chrisduerr/undeadsplit/README.md

# Undead Split Keyboard (v3)

Undead Split v3 is the third revision of my selfmade split mechanical keyboard.
