chrisduerr/undeadsplit/case/case.FCStd

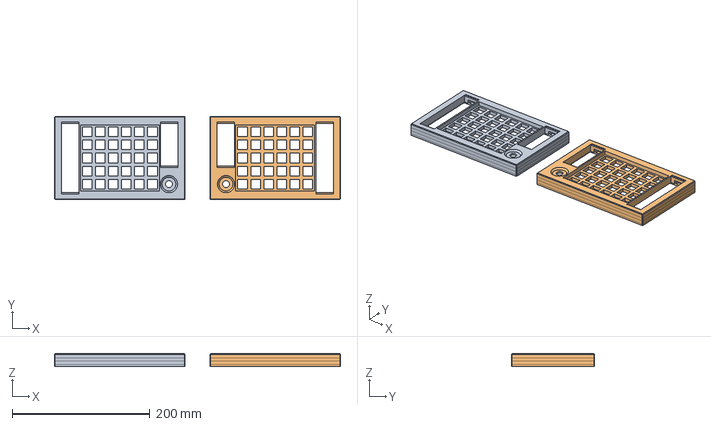
[picture p1: CAD file, 2024-12-27]
case/case.FCStd
416.0 x 121.0 x 18.5 mm
Body (Mirror #1)
