chrisduerr/undeadsplit/pcb/undead_split.kicad_pcb

## KiCad design pcb/undead_split.kicad_pcb (2025-04-27)

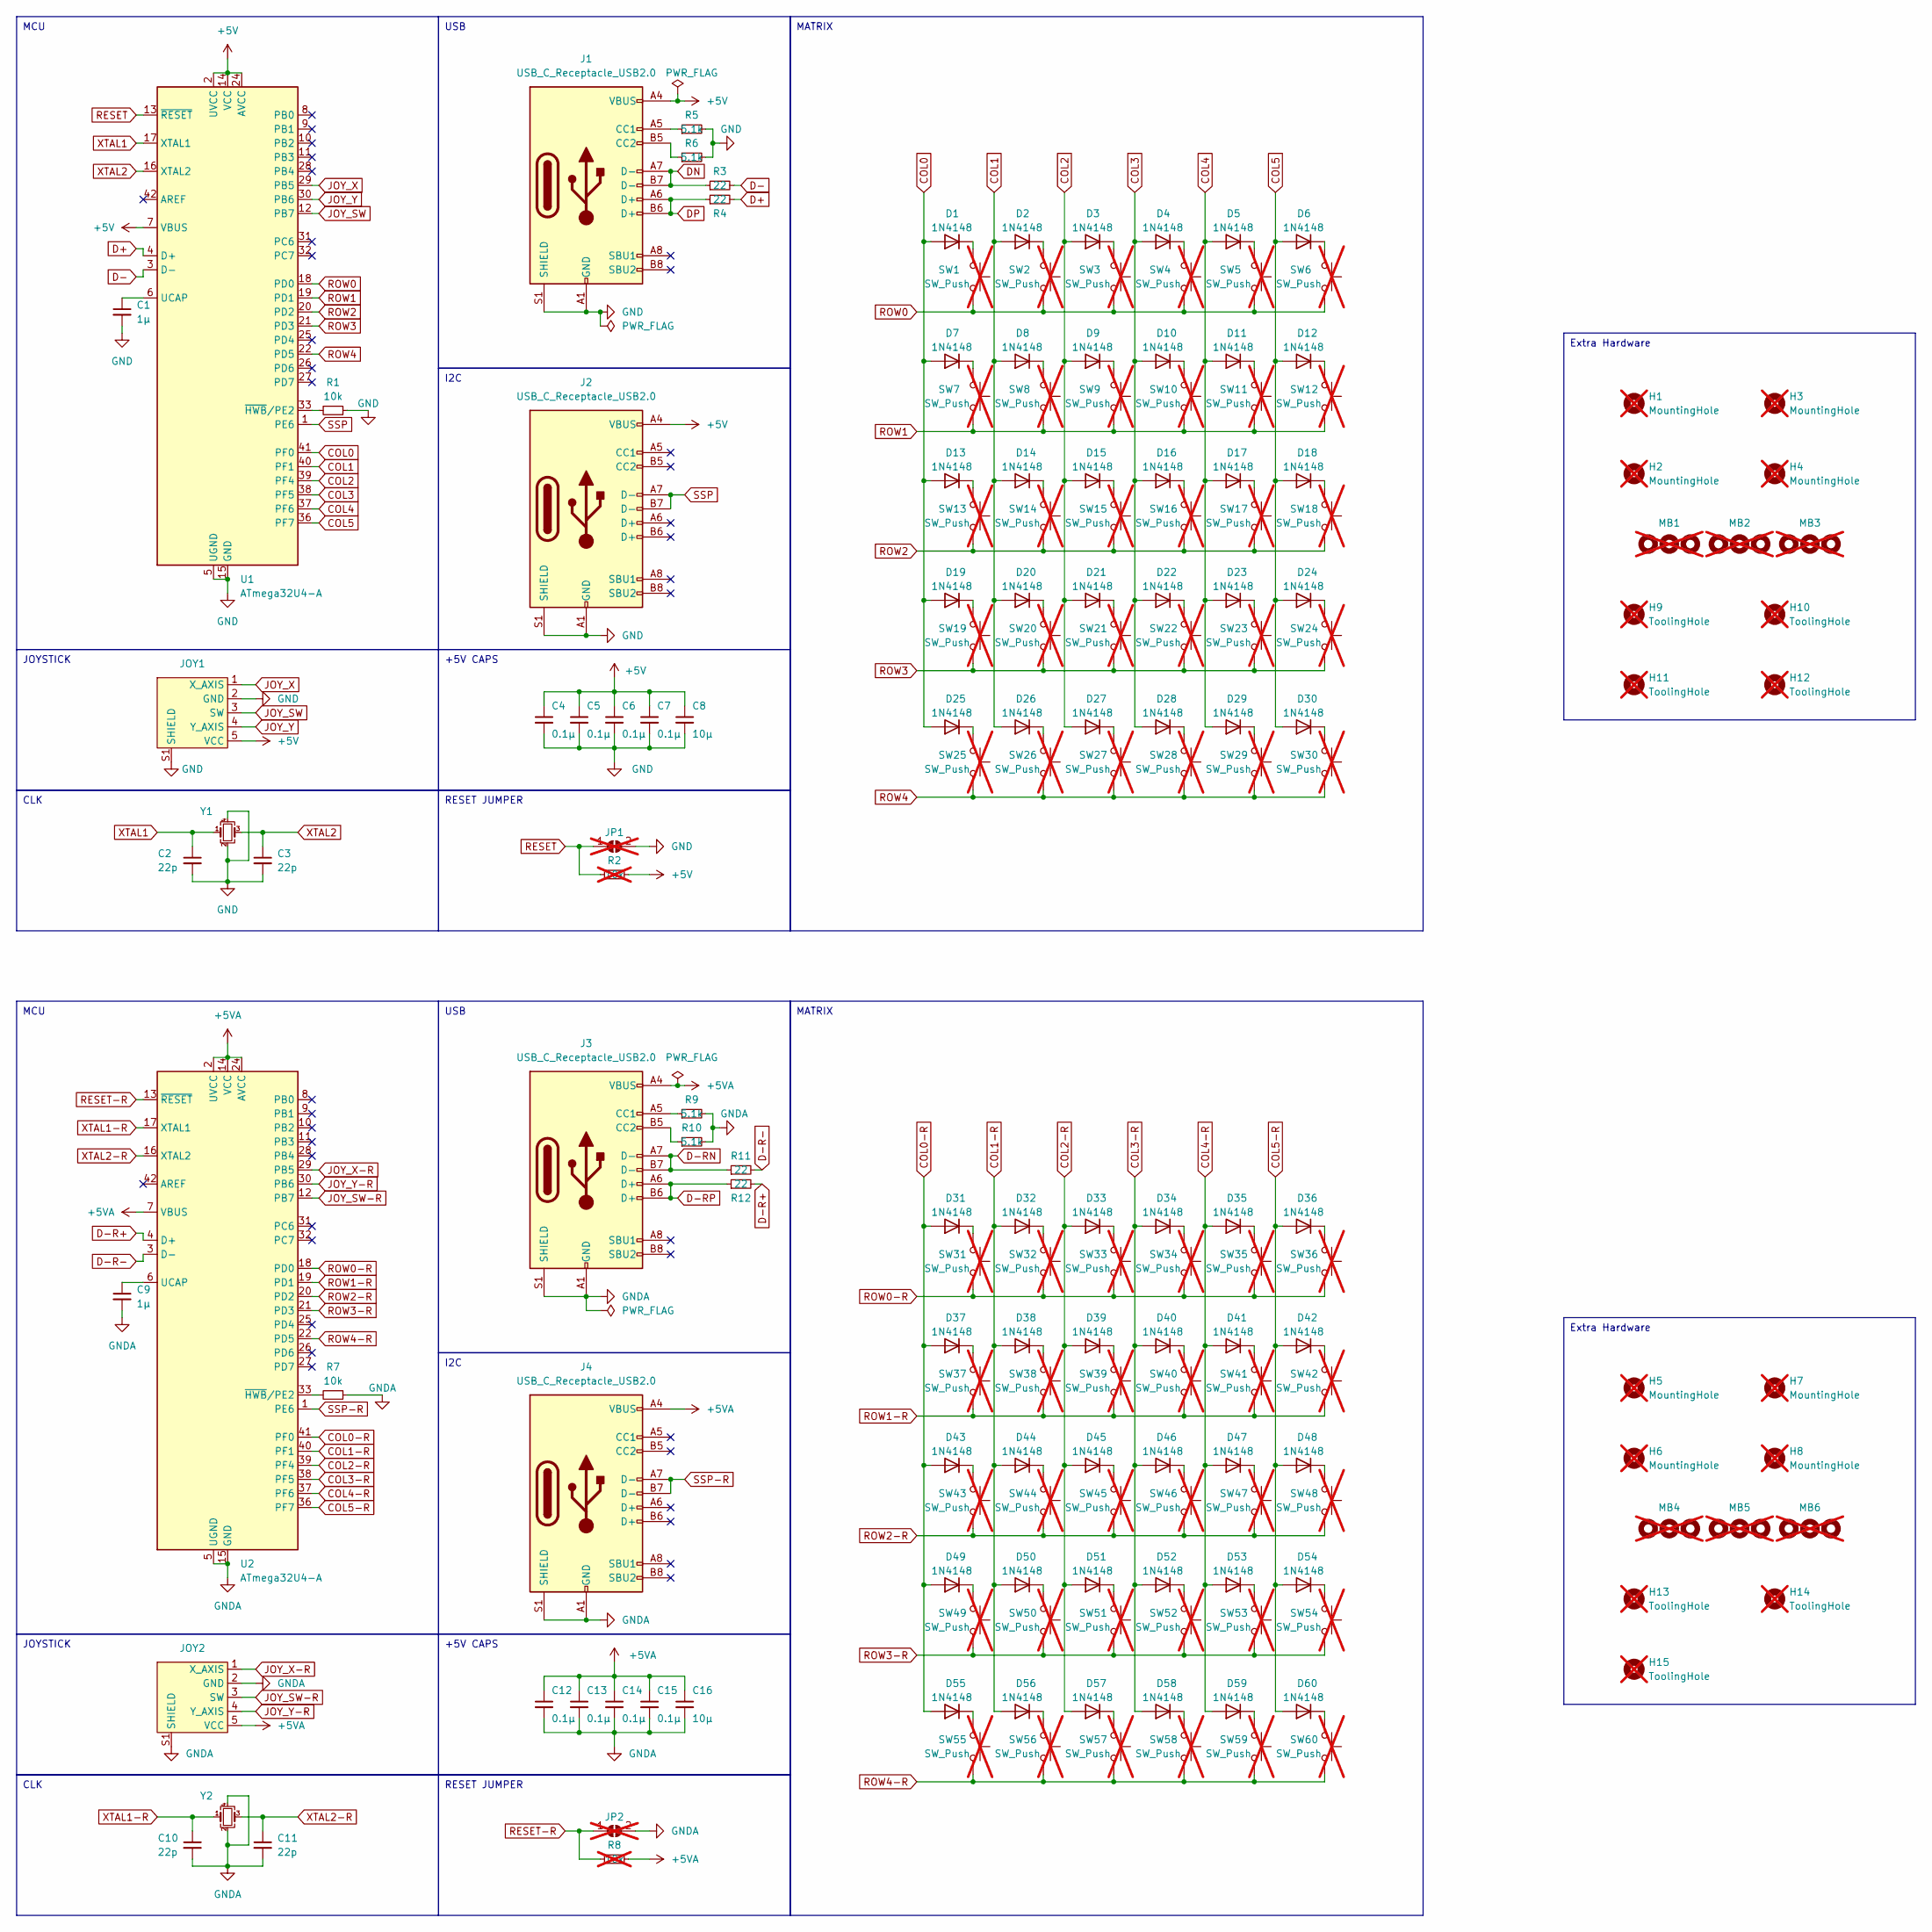
[picture p2: schematic undead_split.kicad_sch, Undead Split]

Parts:
C1, C9: 1µ; capacitor; JLCPCB Part # C28323
C2, C3, C10, C11: 22p; capacitor; JLCPCB Part # C1804
C4, C5, C6, C7, C12, C13, C14, C15: 0.1µ; capacitor; JLCPCB Part # C1711
C8, C16: 10µ; capacitor; JLCPCB Part # C17024
D1, D2, D3, D4, D5, D6, D7, D8, D9, D10, D11, D12, D13, D14, D15, D16, D17, D18, D19, D20, D21, D22, D23, D24, D25, D26, D27, D28, D29, D30, D31, D32, D33, D34, D35, D36, D37, D38, D39, D40, D41, D42, D43, D44, D45, D46, D47, D48, D49, D50, D51, D52, D53, D54, D55, D56, D57, D58, D59, D60: 1N4148; D_DO-35_SOD27_P7.62mm_Horizontal; JLCPCB Part # C402212
H1, H2, H3, H4, H5, H6, H7, H8: MountingHole; MountingHole_2.2mm_M2; not fitted
H9, H10, H11, H12, H13, H14, H15: ToolingHole; tooling_hole; not fitted
J1, J2, J3, J4: USB_C_Receptacle_USB2.0; USB_C_Receptacle_GCT_USB4105-xx-A_16P_TopMnt_Horizontal; JLCPCB Part # C393939
JOY1, JOY2: joycon_joystick; JLCPCB Part # C5213747
JP1, JP2: SolderJumper-2_P1.3mm_Open_Pad1.0x1.5mm; not fitted
MB1, MB2, MB3, MB4, MB5, MB6: mouse_bites; not fitted
R1, R7: 10k; resistor; JLCPCB Part # C17414
R2, R8: 10k; resistor; JLCPCB Part # C17414; not fitted
R3, R4, R11, R12: 22; resistor; JLCPCB Part # C17561
R5, R6, R9, R10: 5.1k; resistor; JLCPCB Part # C27834
SW1, SW2, SW3, SW4, SW5, SW6, SW7, SW8, SW9, SW10, SW11, SW12, SW13, SW14, SW15, SW16, SW17, SW18, SW19, SW20, SW21, SW22, SW23, SW24, SW25, SW26, SW27, SW28, SW29, SW30, SW31, SW32, SW33, SW34, SW35, SW36, SW37, SW38, SW39, SW40, SW41, SW42, SW43, SW44, SW45, SW46, SW47, SW48, SW49, SW50, SW51, SW52, SW53, SW54, SW55, SW56, SW57, SW58, SW59, SW60: SW_Push; CherryMX_Hotswap; not fitted
U1, U2: ATmega32U4-A; TQFP-44_10x10mm_P0.8mm; JLCPCB Part # C44854
Y1, Y2: Crystal_SMD_3225-4Pin_3.2x2.5mm_HandSoldering; JLCPCB Part # C13738

Connections:
+5V: C4.1, C5.1, C6.1, C7.1, C8.1, J1.A4 (VBUS), J1.A9 (VBUS), J1.B4 (VBUS), J1.B9 (VBUS), J2.A4 (VBUS), J2.A9 (VBUS), J2.B4 (VBUS), J2.B9 (VBUS), JOY1.5 (VCC), R2.2, U1.2 (UVCC), U1.7 (VBUS), U1.14 (VCC), U1.24 (AVCC), U1.34 (VCC), U1.44 (AVCC)
+5VA: C12.1, C13.1, C14.1, C15.1, C16.1, J3.A4 (VBUS), J3.A9 (VBUS), J3.B4 (VBUS), J3.B9 (VBUS), J4.A4 (VBUS), J4.A9 (VBUS), J4.B4 (VBUS), J4.B9 (VBUS), JOY2.5 (VCC), R8.2, U2.2 (UVCC), U2.7 (VBUS), U2.14 (VCC), U2.24 (AVCC), U2.34 (VCC), U2.44 (AVCC)
COL0: D1.2 (A), D7.2 (A), D13.2 (A), D19.2 (A), D25.2 (A), U1.41 (PF0)
COL0-R: D31.2 (A), D37.2 (A), D43.2 (A), D49.2 (A), D55.2 (A), U2.41 (PF0)
COL1: D2.2 (A), D8.2 (A), D14.2 (A), D20.2 (A), D26.2 (A), U1.40 (PF1)
COL1-R: D32.2 (A), D38.2 (A), D44.2 (A), D50.2 (A), D56.2 (A), U2.40 (PF1)
COL2: D3.2 (A), D9.2 (A), D15.2 (A), D21.2 (A), D27.2 (A), U1.39 (PF4)
COL2-R: D33.2 (A), D39.2 (A), D45.2 (A), D51.2 (A), D57.2 (A), U2.39 (PF4)
COL3: D4.2 (A), D10.2 (A), D16.2 (A), D22.2 (A), D28.2 (A), U1.38 (PF5)
COL3-R: D34.2 (A), D40.2 (A), D46.2 (A), D52.2 (A), D58.2 (A), U2.38 (PF5)
COL4: D5.2 (A), D11.2 (A), D17.2 (A), D23.2 (A), D29.2 (A), U1.37 (PF6)
COL4-R: D35.2 (A), D41.2 (A), D47.2 (A), D53.2 (A), D59.2 (A), U2.37 (PF6)
COL5: D6.2 (A), D12.2 (A), D18.2 (A), D24.2 (A), D30.2 (A), U1.36 (PF7)
COL5-R: D36.2 (A), D42.2 (A), D48.2 (A), D54.2 (A), D60.2 (A), U2.36 (PF7)
D+: R4.2, U1.4 (D+)
D-: R3.2, U1.3 (D-)
D-R+: R12.2, U2.4 (D+)
D-R-: R11.2, U2.3 (D-)
D-RN: J3.A7 (D-), J3.B7 (D-), R11.1
D-RP: J3.A6 (D+), J3.B6 (D+), R12.1
DN: J1.A7 (D-), J1.B7 (D-), R3.1
DP: J1.A6 (D+), J1.B6 (D+), R4.1
GND: C1.2, C2.2, C3.2, C4.2, C5.2, C6.2, C7.2, C8.2, J1.A1 (GND), J1.A12 (GND), J1.B1 (GND), J1.B12 (GND), J1.S1 (SHIELD), J2.A1 (GND), J2.A12 (GND), J2.B1 (GND), J2.B12 (GND), J2.S1 (SHIELD), JOY1.2 (GND), JOY1.S1 (SHIELD), JP1.2 (B), R1.1, R5.2, R6.2, U1.5 (UGND), U1.15 (GND), U1.23 (GND), U1.35 (GND), U1.43 (GND), Y1.2, Y1.4
GNDA: C9.2, C10.2, C11.2, C12.2, C13.2, C14.2, C15.2, C16.2, J3.A1 (GND), J3.A12 (GND), J3.B1 (GND), J3.B12 (GND), J3.S1 (SHIELD), J4.A1 (GND), J4.A12 (GND), J4.B1 (GND), J4.B12 (GND), J4.S1 (SHIELD), JOY2.2 (GND), JOY2.S1 (SHIELD), JP2.2 (B), R7.1, R9.2, R10.2, U2.5 (UGND), U2.15 (GND), U2.23 (GND), U2.35 (GND), U2.43 (GND), Y2.2, Y2.4
JOY_SW: JOY1.3 (SW), U1.12 (PB7)
JOY_SW-R: JOY2.3 (SW), U2.12 (PB7)
JOY_X: JOY1.1 (X_AXIS), U1.29 (PB5)
JOY_X-R: JOY2.1 (X_AXIS), U2.29 (PB5)
JOY_Y: JOY1.4 (Y_AXIS), U1.30 (PB6)
JOY_Y-R: JOY2.4 (Y_AXIS), U2.30 (PB6)
unnamed: D1.1 (K), SW1.1
unnamed: D2.1 (K), SW2.1
unnamed: D3.1 (K), SW3.1
unnamed: D4.1 (K), SW4.1
unnamed: D5.1 (K), SW5.1
unnamed: D6.1 (K), SW6.1
unnamed: D7.1 (K), SW7.1
unnamed: D8.1 (K), SW8.1
unnamed: D9.1 (K), SW9.1
unnamed: D10.1 (K), SW10.1
unnamed: D11.1 (K), SW11.1
unnamed: D12.1 (K), SW12.1
unnamed: D13.1 (K), SW13.1
unnamed: D14.1 (K), SW14.1
unnamed: D15.1 (K), SW15.1
unnamed: D16.1 (K), SW16.1
unnamed: D17.1 (K), SW17.1
unnamed: D18.1 (K), SW18.1
unnamed: D19.1 (K), SW19.1
unnamed: D20.1 (K), SW20.1
unnamed: D21.1 (K), SW21.1
unnamed: D22.1 (K), SW22.1
unnamed: D23.1 (K), SW23.1
unnamed: D24.1 (K), SW24.1
unnamed: D25.1 (K), SW25.1
unnamed: D26.1 (K), SW26.1
unnamed: D27.1 (K), SW27.1
unnamed: D28.1 (K), SW28.1
unnamed: D29.1 (K), SW29.1
unnamed: D30.1 (K), SW30.1
unnamed: D31.1 (K), SW31.1
unnamed: D32.1 (K), SW32.1
unnamed: D33.1 (K), SW33.1
unnamed: D34.1 (K), SW34.1
unnamed: D35.1 (K), SW35.1
unnamed: D36.1 (K), SW36.1
unnamed: D37.1 (K), SW37.1
unnamed: D38.1 (K), SW38.1
unnamed: D39.1 (K), SW39.1
unnamed: D40.1 (K), SW40.1
unnamed: D41.1 (K), SW41.1
unnamed: D42.1 (K), SW42.1
unnamed: D43.1 (K), SW43.1
unnamed: D44.1 (K), SW44.1
unnamed: D45.1 (K), SW45.1
unnamed: D46.1 (K), SW46.1
unnamed: D47.1 (K), SW47.1
unnamed: D48.1 (K), SW48.1
unnamed: D49.1 (K), SW49.1
unnamed: D50.1 (K), SW50.1
unnamed: D51.1 (K), SW51.1
unnamed: D52.1 (K), SW52.1
unnamed: D53.1 (K), SW53.1
unnamed: D54.1 (K), SW54.1
unnamed: D55.1 (K), SW55.1
unnamed: D56.1 (K), SW56.1
unnamed: D57.1 (K), SW57.1
unnamed: D58.1 (K), SW58.1
unnamed: D59.1 (K), SW59.1
unnamed: D60.1 (K), SW60.1
unnamed: J1.A5 (CC1), R5.1
unnamed: J1.B5 (CC2), R6.1
unnamed: J3.A5 (CC1), R9.1
unnamed: J3.B5 (CC2), R10.1
unnamed: C1.1, U1.6 (UCAP)
unnamed: R1.2, U1.33 (~HWB/PE2)
unnamed: C9.1, U2.6 (UCAP)
unnamed: R7.2, U2.33 (~HWB/PE2)
RESET: JP1.1 (A), R2.1, U1.13 (~RESET)
RESET-R: JP2.1 (A), R8.1, U2.13 (~RESET)
ROW0: SW1.2, SW2.2, SW3.2, SW4.2, SW5.2, SW6.2, U1.18 (PD0)
ROW0-R: SW31.2, SW32.2, SW33.2, SW34.2, SW35.2, SW36.2, U2.18 (PD0)
ROW1: SW7.2, SW8.2, SW9.2, SW10.2, SW11.2, SW12.2, U1.19 (PD1)
ROW1-R: SW37.2, SW38.2, SW39.2, SW40.2, SW41.2, SW42.2, U2.19 (PD1)
ROW2: SW13.2, SW14.2, SW15.2, SW16.2, SW17.2, SW18.2, U1.20 (PD2)
ROW2-R: SW43.2, SW44.2, SW45.2, SW46.2, SW47.2, SW48.2, U2.20 (PD2)
ROW3: SW19.2, SW20.2, SW21.2, SW22.2, SW23.2, SW24.2, U1.21 (PD3)
ROW3-R: SW49.2, SW50.2, SW51.2, SW52.2, SW53.2, SW54.2, U2.21 (PD3)
ROW4: SW25.2, SW26.2, SW27.2, SW28.2, SW29.2, SW30.2, U1.22 (PD5)
ROW4-R: SW55.2, SW56.2, SW57.2, SW58.2, SW59.2, SW60.2, U2.22 (PD5)
SSP: J2.A7 (D-), J2.B7 (D-), U1.1 (PE6)
SSP-R: J4.A7 (D-), J4.B7 (D-), U2.1 (PE6)
XTAL1: C2.1, U1.17 (XTAL1), Y1.1
XTAL1-R: C10.1, U2.17 (XTAL1), Y2.1
XTAL2: C3.1, U1.16 (XTAL2), Y1.3
XTAL2-R: C11.1, U2.16 (XTAL2), Y2.3

Notes on the sheet:
CLK
Extra Hardware
JOYSTICK
MCU
MATRIX
+5V CAPS
RESET JUMPER
I2C
USB

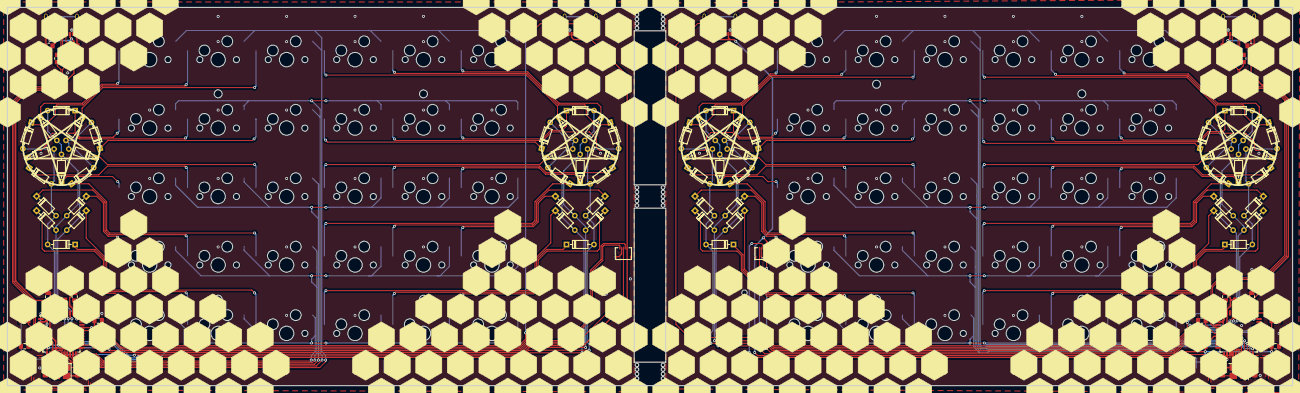
[picture p3: board undead_split.kicad_pcb from above]

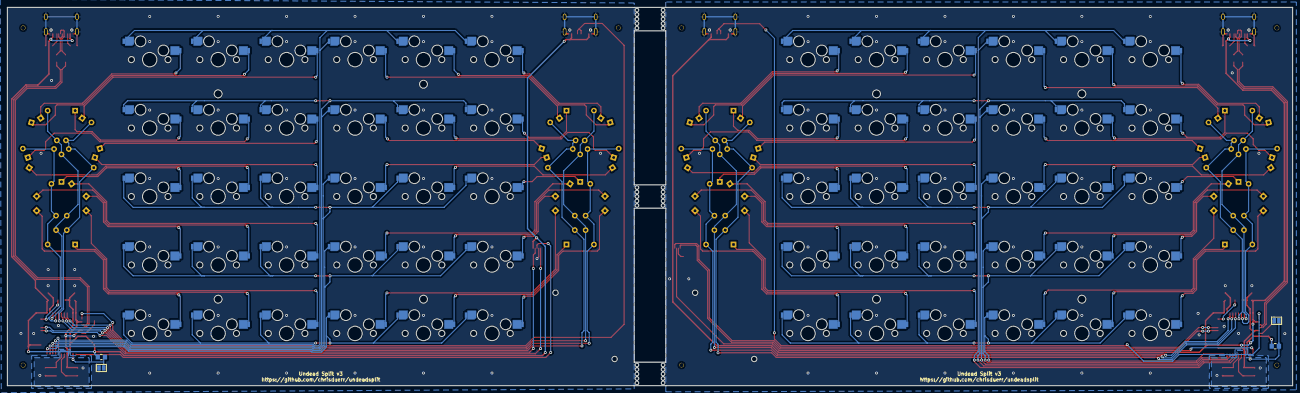
[picture p4: board undead_split.kicad_pcb from below]

Board: 2 copper layers, 356.8 x 105.0 mm, 181 parts (4 on the bottom side), 116 nets.
