chrisduerr/undeadsplit/(commit log)

2022-10-10 Add UndeadSplit PCB
    [UndeadSplit.kicad_pcb, UndeadSplit.kicad_sch, UndeadSplit.sch, bottom_plate.kicad_pcb, sofle_v2_oled_cover_0.1.dxf, sofle_v2_oled_cover_0.1.f3d, sofle_v2_oled_cover_0.1.step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]
2023-09-06 Add keyboard case
    [bottom_plate.kicad_pcb, case.FCStd, case.stl, sofle_v2_oled_cover_0.1.dxf, sofle_v2_oled_cover_0.1.f3d, sofle_v2_oled_cover_0.1.step, top_plate.kicad_pcb]
2023-10-12 Add version 2
    [OLED_Cover.dxf, SofleKeyboard-Eco2_User.dxf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]
2023-10-12 WIP: Case
    [case.FCStd]
2024-12-27 Add final v2 case
    This adds the case as used in version 2 of the keyboard. There are some
    clearance issues with the sticks but it does work after some manual
    intervention which is not visible once assembled.
    [case.FCStd]
2024-12-28 Fix joycon alignment
    This fixes an issue with the joycon where it was incorrectly centered to
    the chassis, instead of being centered to the joycon. This has caused a
    slight misalignment of the joycon since it is not centered in its case.
2024-12-29 Add JLCPCB part IDs
    [undead_split.kicad_pcb, undead_split.kicad_sch, undead_split_v2.kicad_sch]
2024-12-29 Add JLCPCB production requirements
    [undead_split.kicad_pcb, undead_split.kicad_sch]
2024-12-29 Fix footprint position and rotation
    This change allows for easy JLCPCB production without having to perform
    any manual placement or rotation steps.
    [undead_split.kicad_pcb, undead_split.kicad_sch]
2025-01-07 Fix version on silkscreen
    [undead_split.kicad_pcb]
2025-01-07 Remove hole labels from silkscreen
    [undead_split.kicad_pcb]
2025-01-07 Fix vertical joycon alignment
    [undead_split.kicad_pcb]
2025-04-27 Update to new KiCad version
    [undead_split.kicad_pcb]
2025-04-27 Remove additional labels from PCB
    [undead_split.kicad_pcb]
